Gustavo-V-F/water-leak-detection/(commit log)

2022-02-16 Add STM32F103C8T6 (blue pill) prototype code
2022-02-16 Revert "Add STM32F103C8T6 (blue pill) prototype code"
    This reverts commit 287ab8998e007cea87bb7e5195f51b5b069019f2.
2022-02-16 Add correct STM32F103C8T6 (blue pill) prototype code
    [Pressure_sensor.cfg]
2022-02-16 Create README.md containing prototype information
2022-03-16 Added prototype images
2022-03-18 Added sample acquisition images
2022-03-18 Added jupyter notebook python scripts
    [pressure_sensor_data_raw.csv, pressure_sensor_data_raw2.csv]
