Gustavo-V-F/water-leak-detection/(notices)

Notices in the files:
Pressure_sensor/Core/Src/main.c:
Copyright (c) 2022 STMicroelectronics.
All rights reserved.
This software is licensed under terms that can be found in the LICENSE file
